WB2CBA/TinyDX---Tiny-Digital-Modes-HF-Transceiver/TinyDX RX DFM.jpg

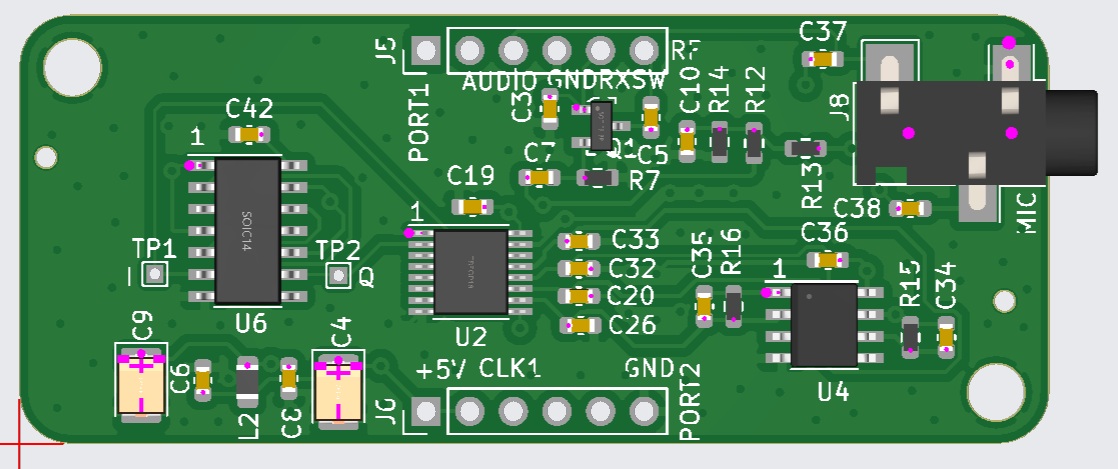
TinyDX RX DFM.jpg
