WB2CBA/TinyDX---Tiny-Digital-Modes-HF-Transceiver/TinyDX TX DFM.jpg

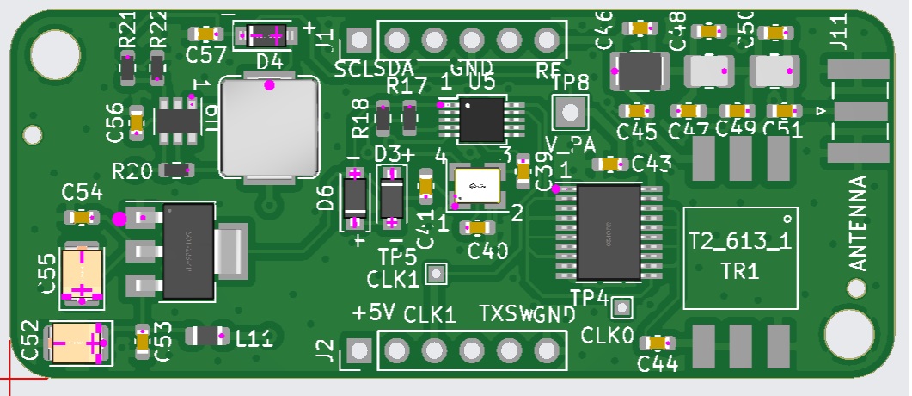
TinyDX TX DFM.jpg
