WB2CBA/TinyDX---Tiny-Digital-Modes-HF-Transceiver/TinyDX MAIN DFM.jpg

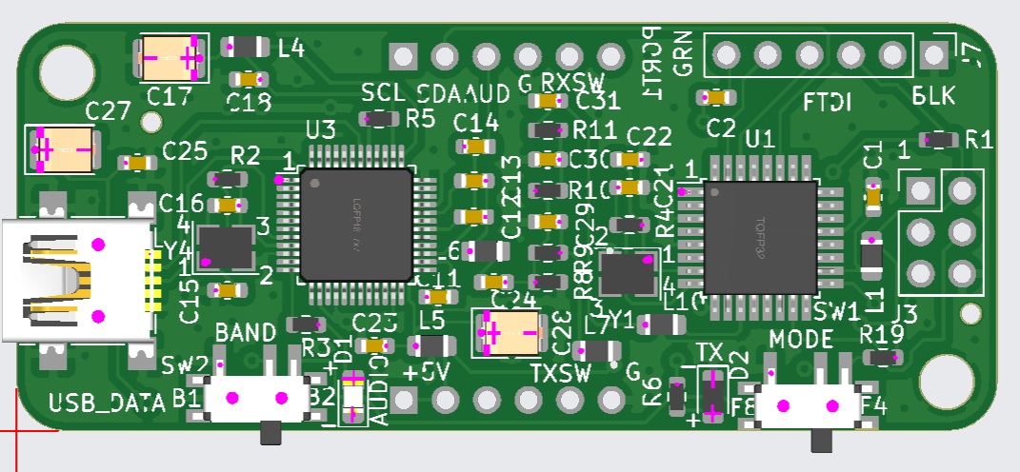
TinyDX MAIN DFM.jpg
