WB2CBA/TinyDX---Tiny-Digital-Modes-HF-Transceiver/TinyDX.jpg

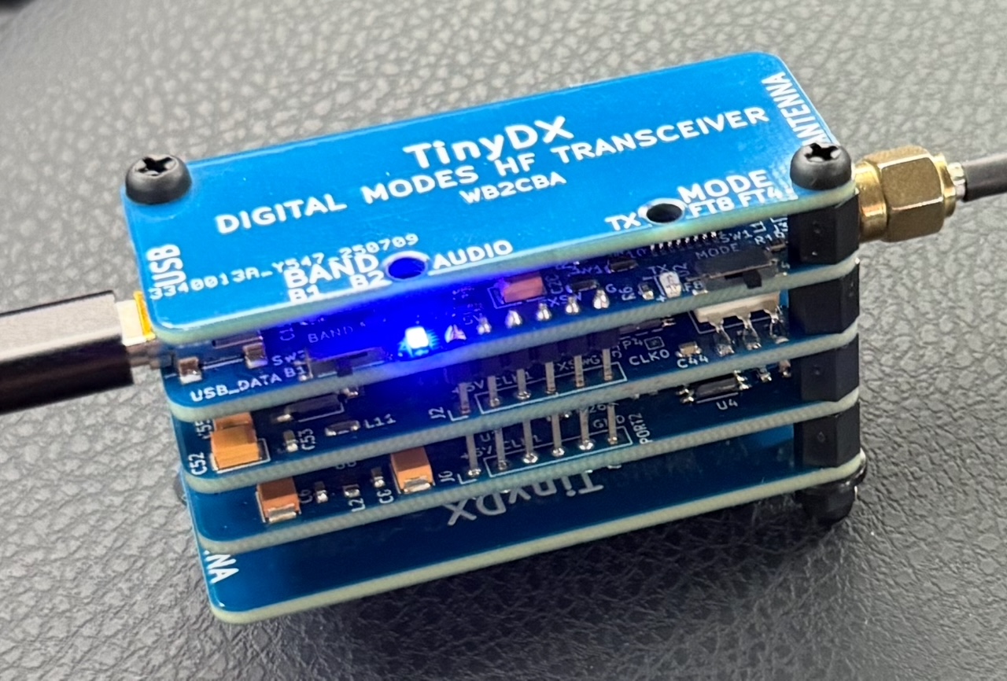
TinyDX.jpg
