WB2CBA/TinyDX---Tiny-Digital-Modes-HF-Transceiver/JLCPCB SMT ORDER PLACEMENT GUIDE.pdf

# SMT PCB boards JLCPCB ordering guide:

As an example, this guide covers Usdx SOTA PCB Board ordering. Applies to all SMD board orders from JLCPCB.

Now let’s talk about the most important subject! How we are going to get these SMD boards manufactured! Here is a short guide for ordering SMD manufactured boards from JLCPCB!

Surface mount parts might be intimidating for most of us. They need healthy eyes and steady hands to solder. This SMT pcb manufacturing service cures that problem by manufacturing PCBs and installing all smd parts on them in a controlled factory environment! An example of cost for this service: uSDX SOTA Main board will cost you less than 15 US Dollars each for a batch of 10 PCB orders including DHL shipping! This means a PCB with 85% of parts assembled including that SI5351 beast! The trick is the more units of pcb you order the less you pay for one pcb in cost.

The reason for that is there are certain one time fee costs JLCPCB adds to their invoice. Those are SMT setting up fee, extended parts fee etc. These are one time cost charges for each pcb order batch. So if we order 5 pieces of pcb that surcharge cost will be shared by 5 pcbs. If we order 30 pcbs then that surcharge will be divided by 30 and will be less per pcb. That’s why it is always order pcbs in larger quantities as a group buy. Ok how we will do this smt ordering business!

I’ll explain this as simple as possible in steps:

1- We will need Production files:
In order to place an order a SMT manufactured PCB from JLCPCB we need three files
– GERBER file (contains all the files to manufacture the PCB board itself)
– BOM File(contains all smd parts, their smd footprints and JLCPCB stock numbers for each part)
– Foot print position file (it is also called as centroid file – coordinates of each smd part on the pcb for pick and place robot)

All these files are included in each boards ZIP file under production file directory.

2- Create an account on www.jlcpcb.com. Follow instructions on their site.

3- After creating your account with all your credentials click on instant quote button

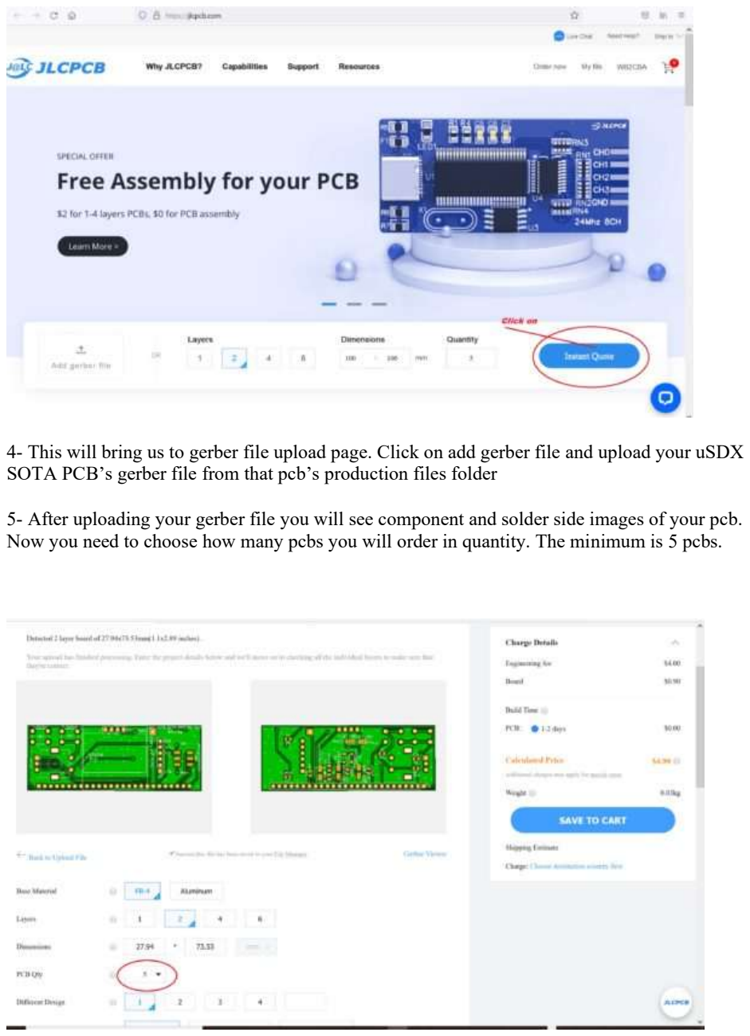
[picture p24: page 2]

4- This will bring us to gerber file upload page. Click on add gerber file and upload your uSDX SOTA PCB’s gerber file from that pcb’s production files folder

5- After uploading your gerber file you will see component and solder side images of your pcb. Now you need to choose how many pcbs you will order in quantity. The minimum is 5 pcbs.

6- Now scroll down the same gerber upload page until you see the Free SMT Assembly for your PCB slide switch which should be light grey inactive position. Now slide it to activate. You should see below screen with top and bottom sides of your PCB. In this case I used uSDX SOTA 128×64 OLED Display as an example. In this display smd populated side is bottom side so I chose assemble bottom side. Now without touching anything else first click on Confirm then click on NEXT.

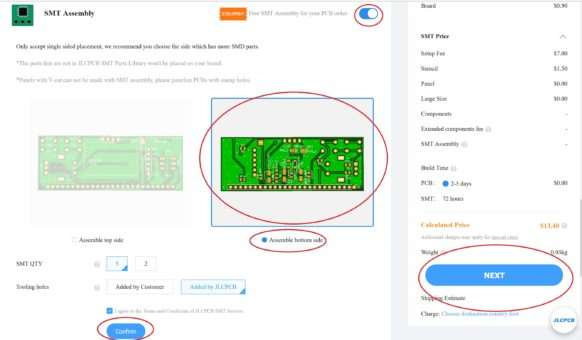
[picture p25: figure]

7- Now we will come to this next screen after clicking on NEXT. This is where we upload our BOM file and footprint position file which is marked as CPL button. These files are in your PCB’s production files. First click on Add BOM File button and upload BOM file from production files folder. Then click on Add CPL File Button and upload your footprint position file from your PCB’s production files.

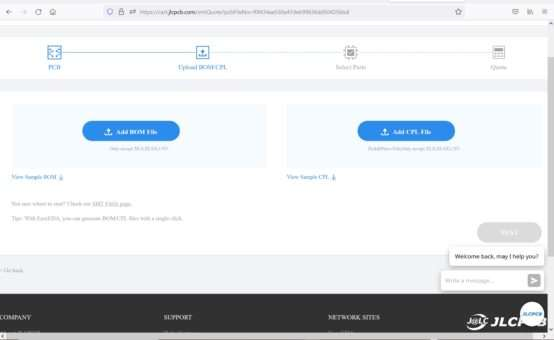
[picture p26: figure]

8- After uploading BOM and CPL files this is the screen which shows all the components of our PCB for SMT manufacturing. This table will show all the component part numbers, total number of each component that will be used for the whole batch of PCBs. Also total cost of each part for the whole batch of PCB order.

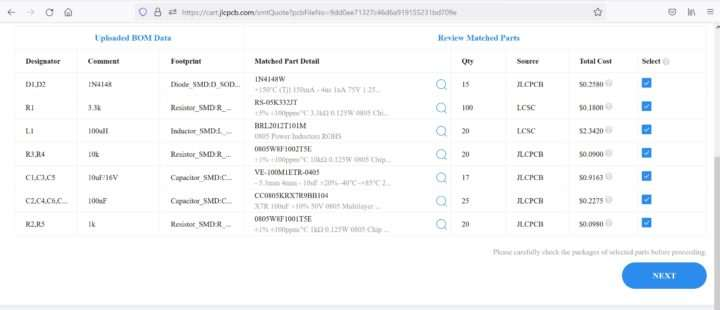
[picture p27: figure]

The most important column in this table is those blue check marks. If you see a blue check mark then it tells you that they have your components and those components have enough stock to manufacture your boards! If one or more parts is not in stock which can happen nowadays as there is chip shortage going on you might get an inventory shortage warning in place of blue check mark. Now JLCPCB does not have that part in stock and can’t pick and place that part and that part will be omitted from pick and place manufacturing. It’s not the end of the world! You can still get your pcb manufactured and hand solder those parts when you receive your pcbs.

Here is an example for that:

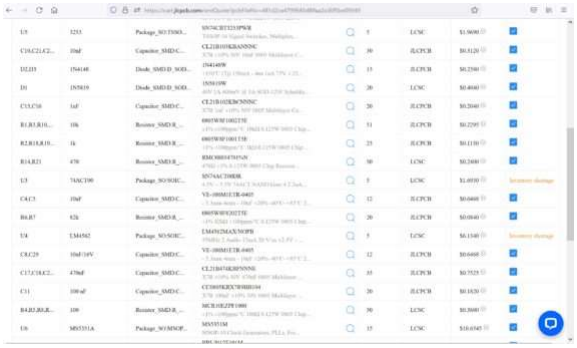
[picture p28: figure]

This is parts list for uSDX SOTA Main PCB. Two parts, 74ACT00DWR and LM4562 is out of stock. The rest of the parts are in stock so no problem with them. We will just order the PCBS and hand solder those parts afterwards. They are easy to solder smd parts.
Now click on NEXT to go to the next ordering screen.

9- This is the next screenshot you will come across which shows your PCB and virtual pick and place finished product layout of your pcb. There might be orientation errors in this PCB virtual parts layout time to time, don’t worry about that. JLCPCB will review your pcb layout and pick and place file and then match those positions. After you ordered your PCB for SMT manufacturing they will review it and correct those mismatches. After this review when you access your account you will see a DFM file icon. If you click on that it will show your previous and manufacturing virtual corrected layout.

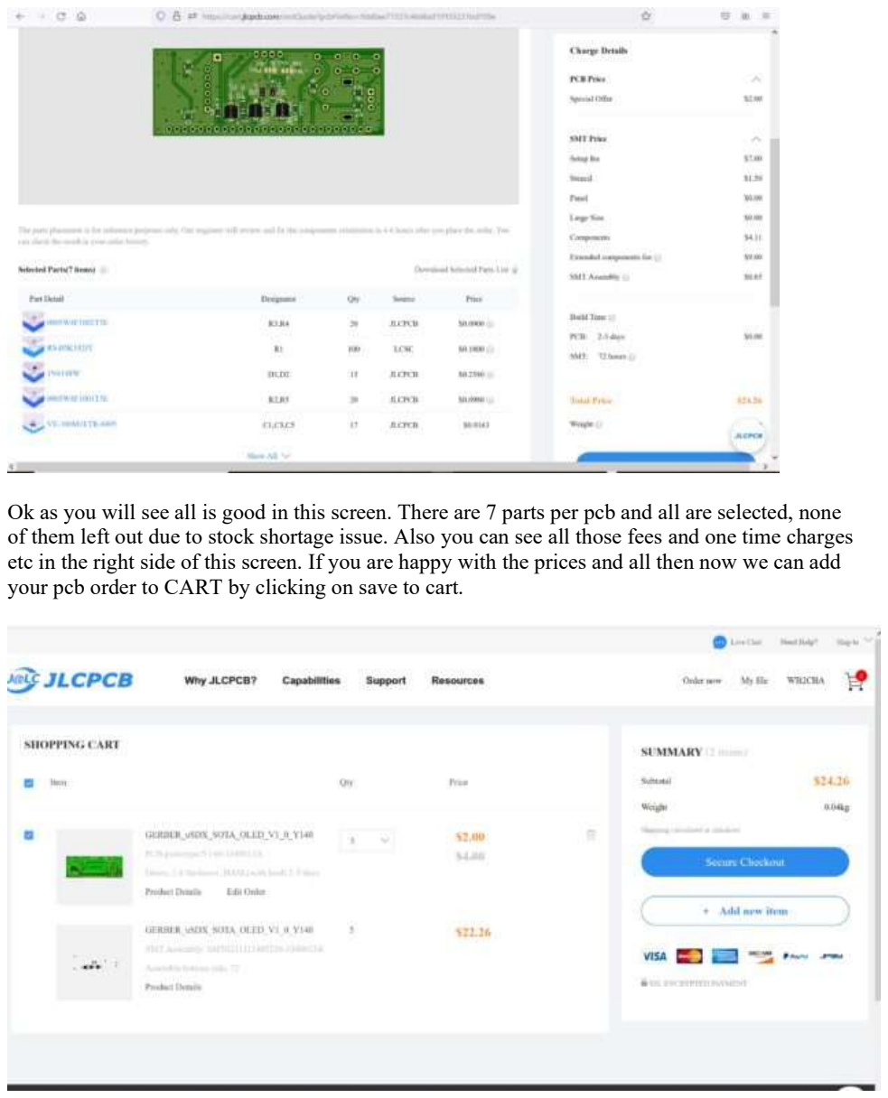
[picture p29: page 6]

Ok as you will see all is good in this screen. There are 7 parts per pcb and all are selected, none of them left out due to stock shortage issue. Also you can see all those fees and one time charges etc in the right side of this screen. If you are happy with the prices and all then now we can add your pcb order to CART by clicking on save to cart.

This CART screen will show your total cost for that ordered pcb batch. Now press on secure checkout and follow the procedure by verifying your address then shipment type and then payment etc.

Now let’s talk again about our nightmare case where some of the parts were out of stock!

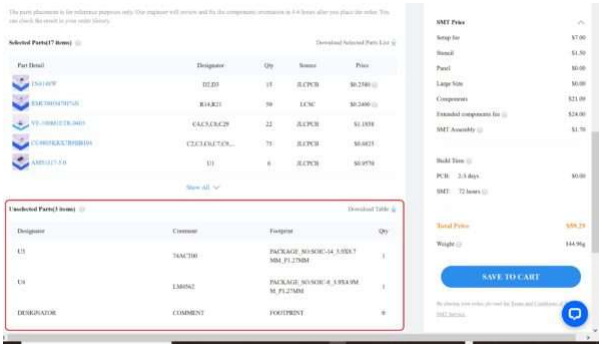
[picture p30: figure]

In uSDX SOTA Main board PCB case two parts were out of stock and we still advanced the order and clicked next. Now as outlined in red box those parts are out of production and not listed on main parts list and will not be shown on virtual smt mounted pcb layout. We can still go ahead with the order and save to cart and get main board pcbs manufactured and when we outsource those parts we can hand solder them. It’s not the end of the world!

Personally I encourage fellow DIY lover hams to give it a try on ordering uSDX SOTA boards smt manufactured from JLCPCB. You will be surprised how cheap they will be for an order of 10 boards. Even with minimum 5 boards is reasonable price. The biggest benefit is that 85% of the transceiver rig is coming to your door step already soldered in!
