WB2CBA/TinyDX---Tiny-Digital-Modes-HF-Transceiver/TinyDX Main PCB Schematic.pdf

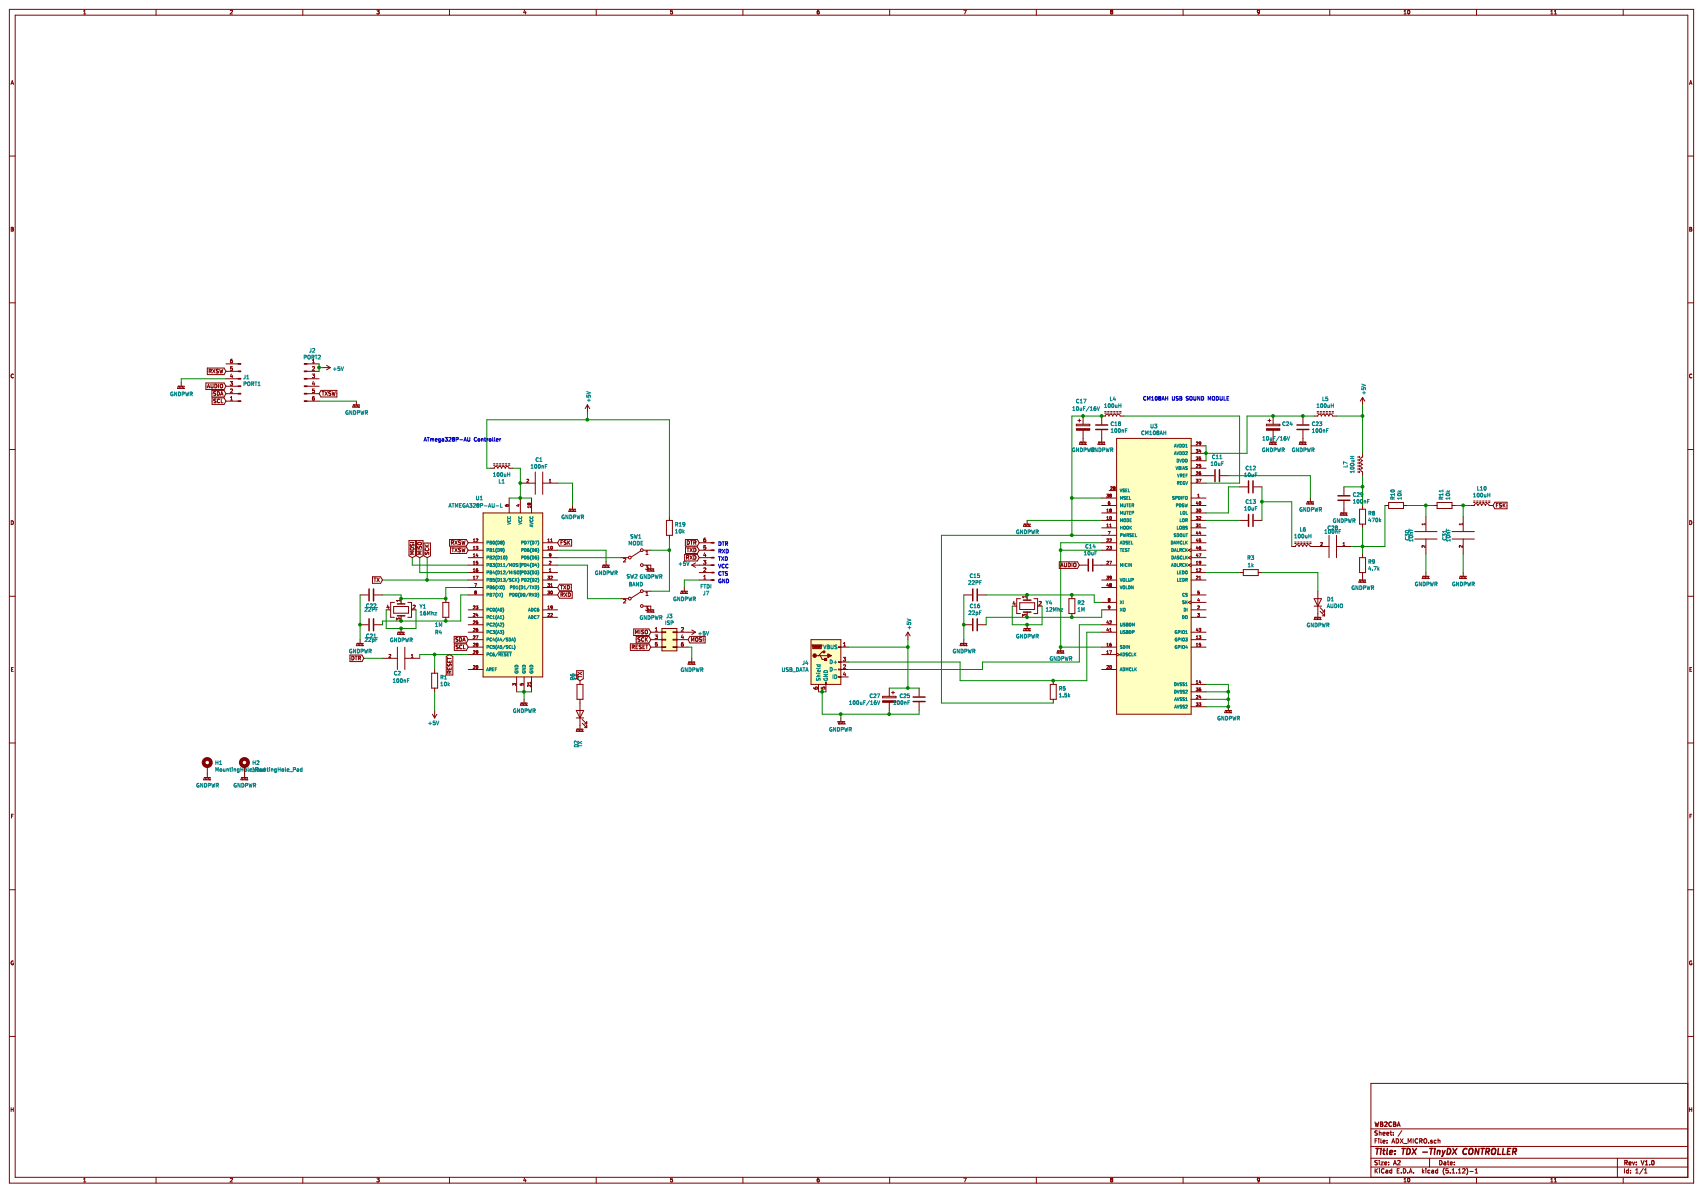
[picture p31: page 1]
