WB2CBA/TinyDX---Tiny-Digital-Modes-HF-Transceiver/TinyDX RX PCB Schematic.pdf

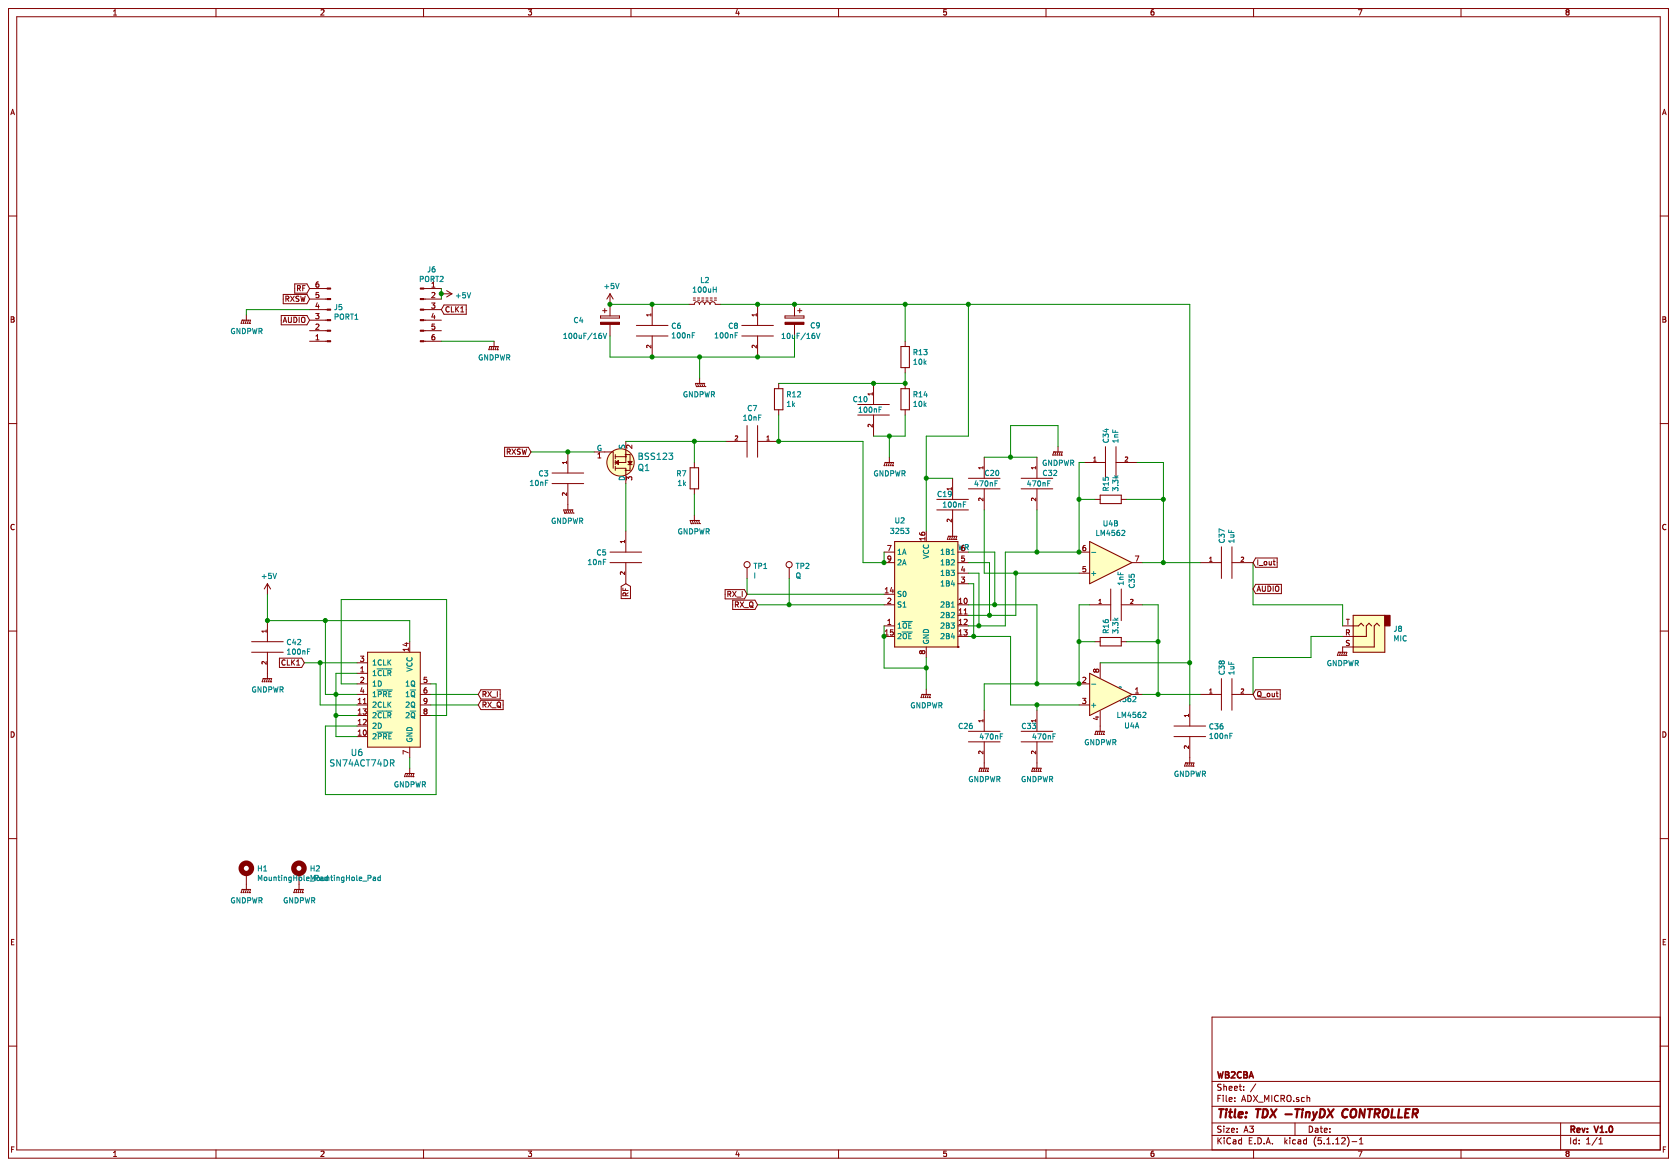
[picture p32: page 1]
