WB2CBA/TinyDX---Tiny-Digital-Modes-HF-Transceiver/TinyDX TX PCB Schematic.pdf

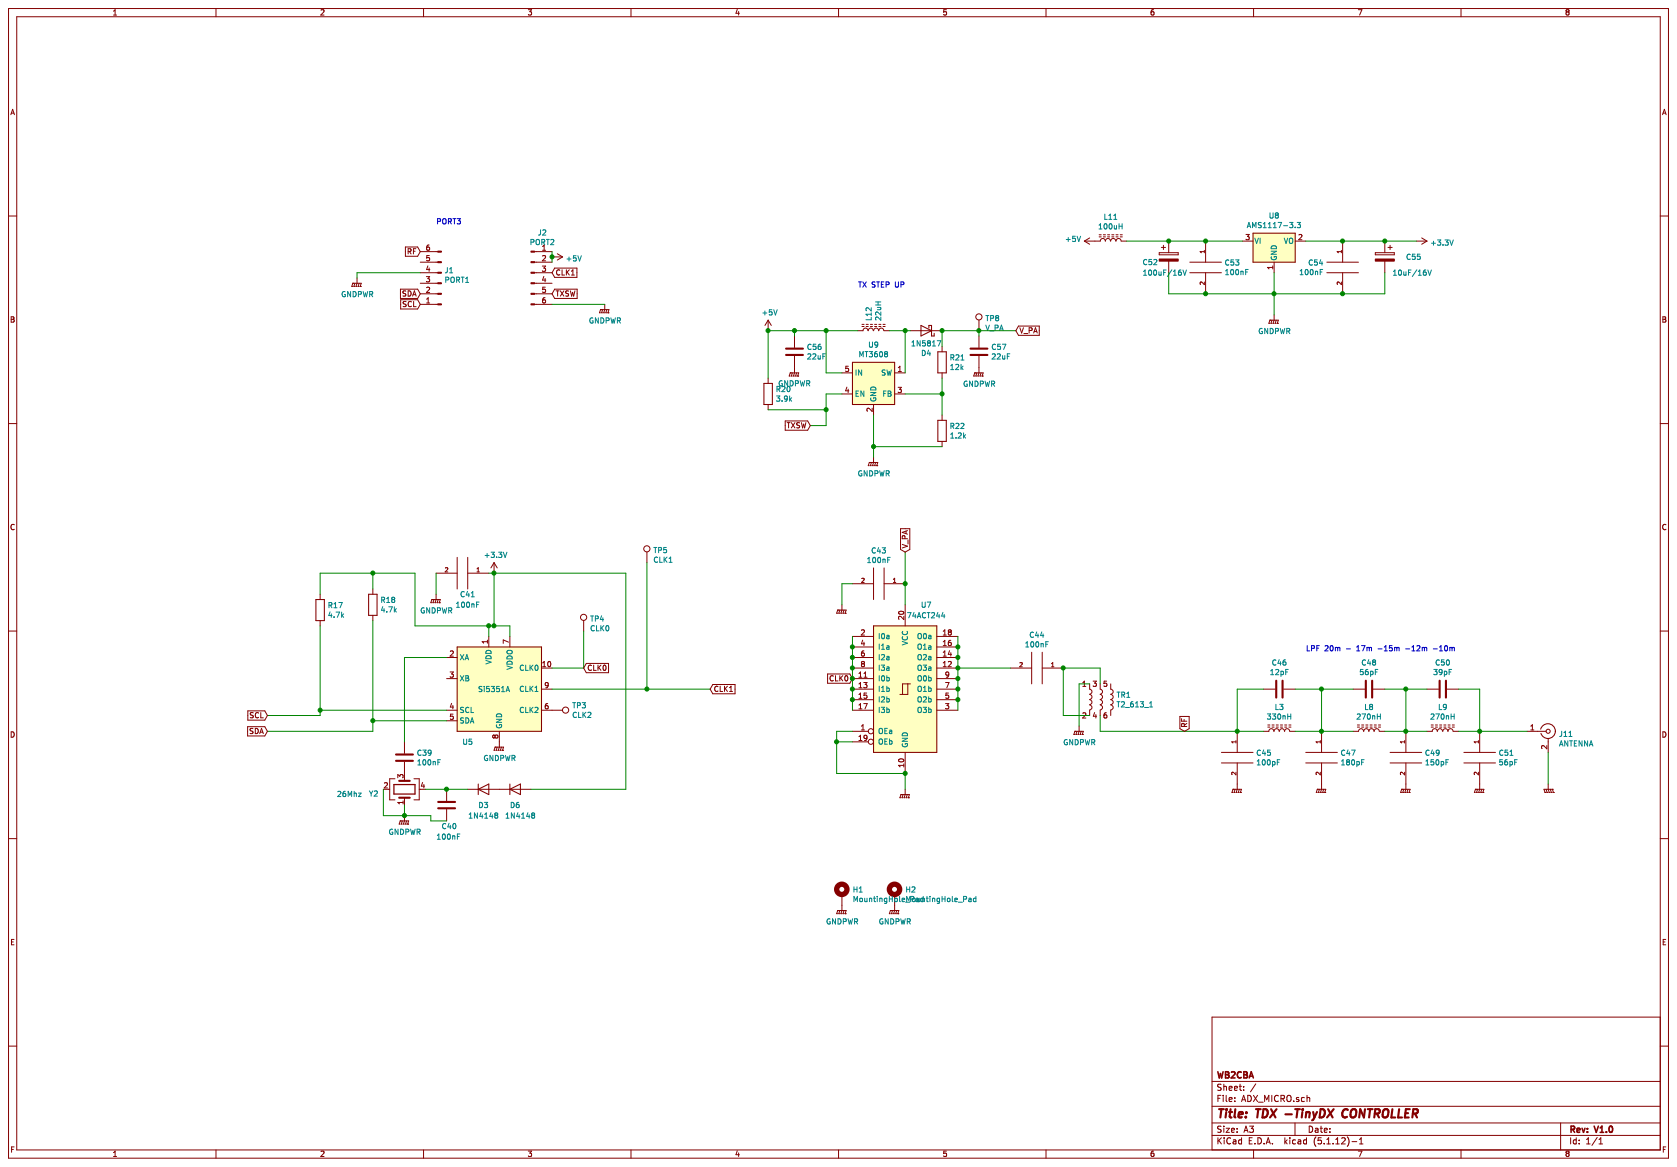
[picture p33: page 1]
